sofiaprutskya-03/arc-2026/firmware/arc_robot/README.md

# Прошивка ARC 2026: маніпулятор на лінійній платформі

Плата: Keyestudio KS0413 (ESP-WROOM-32). У Arduino IDE обирайте **ESP32 Dev Module**. Ядро esp32 ставиться через Boards Manager (перевірено на 3.2.1 і 3.3.12; на Windows надійніше ставиться 3.2.1). Плати ESP32-C3/C6 не вибирати: помилка `esp-rv32 ... cc1plus.exe` означає саме неправильну плату або пошкоджене встановлення ядра.

Файли:
- `arc_robot.ino` — уся прошивка в одному файлі. Угорі блок налаштувань: піни, межі кутів, швидкості, сітка, джойстик. Усе, що залежить від заліза, змінюється тільки там. Нижче йде логіка: серво, платформа, джойстик, ручний режим, напівавтомат, ввід із клавіатури та Serial.
- `WIRING.md` — підключення і живлення.
- `BREADBOARD.md` — збирання на макетці, отвір за отвором.

## На чому побудовано

Код не писали з нуля. Усі механізми руху взяті з бібліотек у `research/references`, а модель «навчи позу → відтвори» з проєкту Keyestudio 4DOF. Огляд усіх готових проєктів: [research/ready-projects/REVIEW.md](../../research/ready-projects/REVIEW.md).

| Бібліотека | Що робить | Чому саме вона |
|---|---|---|
| ServoEasing 3.6.0 | плавні траєкторії серв (квадратичний розгін/гальмування), синхронний рух суглобів | зрілий проєкт, є приклад RobotArmControl. Працює в режимі опитування: в ESP32-гілці режиму переривань автор сам описує гонку з таймером ("CORRUPT HEAP") |
| ESP32Servo 3.2.1 | PWM 50 Гц для SG90 | потрібна ServoEasing на ESP32 |
| AccelStepper 1.64 | 28BYJ-48 + ULN2003, режим HALF4WIRE, розгін і гальмування | FastAccelStepper працює тільки з драйверами STEP/DIR, з ULN2003 він не сумісний |
| Keypad 3.1.1 | клавіатура 4x4 з подіями «натиснуто / утримується / відпущено» | ту саму бібліотеку використовує урок KS5011 «Keypad Door» |

Що додано поверх бібліотек:
1. **Ручний рух з обмеженням прискорення.** Поки клавішу тримають, суглоб плавно набирає швидкість. Коли її відпускають, суглоб плавно гальмує. Біля межі швидкість зменшується заздалегідь, тому рука не б'ється в упор.
2. **Синхронні переходи між позами.** Три суглоби стартують і зупиняються одночасно, тому траєкторія передбачувана.
3. **Горизонт клешні.** У 4-серво руці типу MeArm / Keyestudio 4DOF його тримає механіка паралелограма, тому `HAS_WRIST_SERVO false`. Якщо зап'ясток окремим серво, прошивка кожні 20 мс рахує `зап'ясток = зсув + K1·плече + K2·лікоть`.
4. **Сітка через навчання.** Позу руки над коміркою і позицію платформи виставляють руками, після чого їх записують однією клавішею. Дані зберігаються у флеш і переживають перезавантаження. На SG90 з люфтами так виходить точніше, ніж через обернену кінематику з неточними довжинами ланок.
5. **Захист позиції рейки.** Позиція рейки записується у флеш після кожної зупинки. Якщо ESP32 перезавантажився посеред руху (наприклад, просіло живлення), прошивка не довіряє збереженій позиції і просить задати нуль заново.
6. **Безпека в автоматі.** Цикл не стартує без заданого нуля. Будь-яка клавіша зупиняє все: рейка плавно гальмує, серво зупиняються на місці. Кожен крок має тайм-аут.
7. **Друк у Serial не смикає кроковий.** Для цього збільшено TX-буфер.

## Підключення

Покрокова схема з живленням від батарей: [WIRING.md](WIRING.md).

```
ULN2003  IN1 IN2 IN3 IN4  ->  GPIO 16 17 5 18
Серво    база 13 | плече 33 | лікоть 27 | клешня 25 | (зап'ясток 14, лише якщо HAS_WRIST_SERVO true)
Клавіатура 4x4 (8 дротів зліва направо): рядки 23 22 21 4, стовпці 26 14 15 19
Джойстик: X 34, Y 35, B 32, V -> 3V3, G -> GND
Кінцевик (необов'язково): GPIO 34 -> кнопка -> GND, плюс резистор 10 кОм з GPIO 34 на 3.3 В
```

Живлення:
- ESP32 живиться від USB ноутбука.
- Серво і ULN2003 живляться від окремого джерела **5–6 В** (павербанк, DC-DC або 4xAA). Відсік 6xAA (близько 9 В) напряму підключати **не можна**.
- **GND усіх джерел з'єднати разом.** Без спільної землі серво смикаються випадково.

## Збірка

Arduino IDE: скопіюйте папки з `research/references/` (ServoEasing, ESP32Servo, AccelStepper, Keypad) у `Documents/Arduino/libraries`, відкрийте `arc_robot.ino` і натисніть Upload. Якщо завантаження не стартує, утримуйте BOOT.

arduino-cli (з кореня репо):

```bash
arduino-cli compile --fqbn esp32:esp32:esp32 --library research/references/ServoEasing --library research/references/ESP32Servo --library research/references/AccelStepper --library research/references/Keypad firmware/arc_robot
```

Serial Monitor: 115200, закінчення рядка будь-яке.

## Клавіші

**Ручний режим**

| Клавіша | Дія |
|---|---|
| 4 / 6 (тримати) | платформа до нуля / від нуля |
| 2 / 8 (тримати) | рука вгору / вниз (плече) |
| 1 / 3 (тримати) | поворот бази |
| 7 / 9 (тримати) | лікоть |
| 5 | клешня відкрити / закрити |
| 0 | безпечна поза |
| # (тримати 1 с) | нуль рейки тут (з кінцевиком запускає пошук нуля) |
| A, потім цифра | записати поточну позу руки як комірку N |
| B, потім цифра | записати поточну позицію платформи як N |
| C | надрукувати стан і всю таблицю |
| D | вирівнювання клешні вкл/викл (лише з серво зап'ястка) |
| * | перейти в напівавтомат |

Ті самі символи працюють із Serial Monitor. Це запасний пульт на випадок, якщо клавіатура відмовить. З монітора клавіші руху роблять один крок: 5° або 10 мм. Додаткові команди монітора: `+`/`-` (лише з серво зап'ястка: зсув горизонту або сам зап'ясток), `x` (скинути калібрування до значень за замовчуванням), `?` (довідка).

**Джойстик (ручний режим):** X — платформа, Y — плече, кнопка — клешня. Швидкість пропорційна відхиленню ручки. База й лікоть керуються з клавіатури. Підключення описане в [WIRING.md](WIRING.md#джойстик).

**Напівавтомат:** `*`, потім 4 цифри `A B C D`, потім `#`. Відхилення джойстика або його кнопка теж працюють як СТОП. Наприклад, `* 1 2 3 1 #` означає: взяти з позиції платформи 1, комірки 2 і покласти на позицію 3, комірку 1. Якщо одразу натиснути `* #`, повториться остання задача. Під час руху будь-яка клавіша означає СТОП.

Послідовність одного циклу: відкрити клешню → безпечна поза → платформа до A → над коміркою B → повільно опустити → захват → пауза → повільно підняти → транспортна поза → платформа до C → над D → опустити → розтиснути → пауза → відвести руку → вихідна поза.

## Калібрування (зробити один раз на зібраному роботі)

1. **Межі суглобів.** Прошивка стартує з вузькими межами (60–120°, база 45–135°) і позою 90° на всіх суглобах. Рухайте кожен суглоб клавішами до краю, де ланка ще нічого не зачіпає, і розширюйте межі поступово, по 10°. Кут видно по `C`. Впишіть межі в налаштування на початку `arc_robot.ino` і перезалийте прошивку.
2. **Напрямки.** Якщо `2` опускає руку, поставте `SHOULDER_UP_DIR (-1)`. Якщо `6` везе платформу до нуля, поставте `RAIL_INVERT_DIR true`.
3. **Кроки на мм.** Задайте нуль (`#`), проїдьте `6` і порівняйте відстань на лінійці з тим, що друкує `C`. Виправте `RAIL_STEPS_PER_MM`.
4. **Горизонт клешні** (лише з серво зап'ястка). Увімкніть вирівнювання (`D`). Підніміть і опустіть плече (2/8). Якщо клешня нахиляється разом із рукою, змініть знак `WRIST_K_SHOULDER`. Те саме перевірте для ліктя (7/9) і `WRIST_K_ELBOW`. Потім виставте горизонт клавішами `+`/`-`.
5. **Сітка.** Для кожної позиції платформи підведіть її (4/6) і натисніть `B` + номер. Для кожної комірки виставте руку так, щоб клешня охоплювала вантаж, і натисніть `A` + номер. Перевірте результат через `C`.
6. **Клешня.** `CLAW_CLOSED` має стискати вантаж, але не впиратися до кінця. Інакше SG90 гуде, гріється і просаджує живлення.
7. **Прогін.** Запустіть `* 1 1 2 2 #` без вантажу, потім із вантажем. Повторіть 5–10 разів.

## Перевірка перед захистом

- [ ] Серво не смикаються при старті (спільна земля, живлення 5–6 В)
- [ ] Під навантаженням ESP32 не перезавантажується (у монітор не падає повторно банер `ARC 2026 robot`)
- [ ] Ручний тест: взяти вантаж з довільного місця й перенести
- [ ] Цикл AB→CD 5 разів поспіль без промахів
- [ ] СТОП посеред циклу зупиняє все, після нього ручний режим працює
- [ ] Після перезавантаження позиція рейки відновлюється (або прошивка просить задати нуль)

## Чого прошивка не знає

- **Пропуск кроків.** Датчика позиції немає, тому якщо 28BYJ-48 пропустить кроки (тугий хід, низька напруга), позиція рейки змістилася. Лікується так: зменшити `RAIL_MAX_SPEED`/`RAIL_ACCEL` і перед демонстрацією задати нуль заново. Кінцевик на GPIO 34 вирішує це остаточно.
- **Нахил клешні.** Без серво зап'ястка горизонт залежить від збирання паралелограма. З серво зап'ястка він розрахований, а не виміряний.
- **Порядок пінів ULN2003.** AccelStepper для 28BYJ-48 вимагає порядок IN1, IN3, IN2, IN4. Він уже зашитий у прошивку. Якщо двигун тільки гуде і дрижить, проблема в дротах, а не в коді.
