sofiaprutskya-03/arc-2026/firmware/arc_robot/BREADBOARD.md

# Збирання на макетці

Деталі з набору Keyestudio KS5011 плюс 4 серво руки:

| Деталь | Скільки | Навіщо |
|---|---|---|
| Плата ESP32 (KS0413) | 1 | керує всім, живиться від USB ноутбука |
| Модуль живлення для макетки | 1 | робить 5 В для серво й двигуна з батарей 9 В |
| Батарейний відсік 6xAA | 1 | живлення серво й двигуна |
| Макетна плата на 830 точок | 1 | з'єднання |
| Серво (SG90 / ES08MA II) | 4 | база, плече, лікоть, клешня |
| Stepper Motor Driver Board (ULN2003) | 1 | драйвер двигуна платформи |
| Кроковий двигун 28BYJ-48 | 1 | платформа |
| Мембранна клавіатура 4x4 | 1 | керування |
| Joystick Module | 1 | ручне керування |
| Дроти «тато-мама» (M-F) | 32 з 40 | ESP32, ULN2003, джойстик → макетка |
| Дроти «тато-тато» (M-M) | 20 з 30 | серво, клавіатура → макетка |
| USB-кабель | 1 | ESP32 ↔ ноутбук |

## Як влаштована макетка

- **Ряд** — номер 1–60. П'ять отворів `a b c d e` одного ряду з'єднані між собою. `f g h i j` того ж ряду теж з'єднані між собою, але **не** з `a–e`: їх розділяє жолобок посередині.
- **Шини** — довгі смуги вздовж країв. Усі отвори червоної смуги (+) з'єднані між собою, так само всі отвори синьої (−).
- Позначення `a10` означає «стовпчик a, ряд 10».

## Правила, щоб нічого не згоріло

1. **ESP32 на макетку не ставимо.** Плата лежить поруч, з'єднання йдуть проводами M-F: «мама» на штир ESP32, «тато» в отвір макетки.
2. **Пін 5V і пін 3V3 ESP32 не з'єднуються з шинами макетки.** З ESP32 на шини йде тільки GND.
3. **Перемикач напруги модуля живлення — на 5 В** (на вашому модулі це повзунок між конденсаторами з позначками 5V / 3V; якщо є жовті перемички, обидві на 5V).
4. **Батареї підключаємо останніми**, коли все зібрано й перевірено.

## Крок 1. Модуль живлення

1. Вставити модуль на **кінець макетки біля ряду 1** так, щоб його нижні штирі увійшли в обидві пари шин. Позначки `+` і `−` на модулі мають збігтися з червоною та синьою смугами.
2. Перемикач напруги поставити в положення **5V**.
3. Штекер батарейного відсіку **поки не вставляти**: він і є вимикачем живлення.

Далі в тексті «шина +5 В» і «шина GND» — це червона й синя смуги **з боку a–e**. Червону смугу з боку f–j не використовуємо.

## Крок 2. Сервоприводи (ряди 10–16)

У серво роз'єм «мама» з трьома дротами: коричневий (GND), червоний (+), помаранчевий (сигнал). У кожен отвір роз'єму вставляємо дріт M-M.

| Серво | Помаранчевий → | ESP32 (M-F) → | Червоний → | Коричневий → |
|---|---|---|---|---|
| база | `e10` | GPIO 13 → `a10` | шина +5 В | шина GND |
| плече | `e12` | GPIO 33 → `a12` | шина +5 В | шина GND |
| лікоть | `e14` | GPIO 27 → `a14` | шина +5 В | шина GND |
| клешня | `e16` | GPIO 25 → `a16` | шина +5 В | шина GND |

Перевірка: в одному ряду мають бути тільки два дроти, сигнал серво й дріт від ESP32. Ряди 11, 13, 15 лишаються порожні, щоб дроти не плутались.

## Крок 3. Двигун платформи (ряди 20–26)

1. Білий роз'єм двигуна 28BYJ-48 вставити в біле гніздо на платі ULN2003 (вставляється тільки одним боком).
2. На платі ULN2003 шість жовтих штирів: `IN1 IN2 IN3 IN4`, `+` (або `V`), `−` (або `G`). На кожен надіти «маму» дроту M-F.

| Штир ULN2003 | Куди «тато» | ESP32 (M-F) → |
|---|---|---|
| IN1 | `e20` | GPIO 16 → `a20` |
| IN2 | `e22` | GPIO 17 → `a22` |
| IN3 | `e24` | GPIO 5 → `a24` |
| IN4 | `e26` | GPIO 18 → `a26` |
| + (V) | шина +5 В | — |
| − (G) | шина GND | — |

## Крок 4. Клавіатура 4x4 (ряди 30–37)

У шлейфа клавіатури 8 контактів «мама». Якщо тримати клавіатуру лицем до себе, рахуємо їх зліва направо 1–8. У кожен вставити дріт M-M.

| Контакт шлейфу | Куди | ESP32 (M-F) → |
|---|---|---|
| 1 (рядок 1) | `j30` | GPIO 23 → `f30` |
| 2 (рядок 2) | `j31` | GPIO 22 → `f31` |
| 3 (рядок 3) | `j32` | GPIO 21 → `f32` |
| 4 (рядок 4) | `j33` | GPIO 4 → `f33` |
| 5 (стовпець 1) | `j34` | GPIO 26 → `f34` |
| 6 (стовпець 2) | `j35` | GPIO 14 → `f35` |
| 7 (стовпець 3) | `j36` | GPIO 15 → `f36` |
| 8 (стовпець 4) | `j37` | GPIO 19 → `f37` |

Клавіатурі живлення не потрібне.

## Крок 5. Джойстик (ряди 42–48)

На модулі джойстика 5 штирів: `Y X B V G`. На кожен надіти «маму» дроту M-F.

| Штир джойстика | Куди «тато» | ESP32 (M-F) → |
|---|---|---|
| X | `j42` | GPIO 34 → `f42` |
| Y | `j44` | GPIO 35 → `f44` |
| B | `j46` | GPIO 32 → `f46` |
| V | `j48` | **3V3** → `f48` |
| G | синя шина з боку f–j (GND) | — |

**Ряд 48 — це живлення 3,3 В від ESP32. Він не з'єднується з жодною шиною.** Якщо V джойстика потрапить на +5 В, можна пошкодити входи ESP32.

## Крок 6. Спільна земля

Один дріт M-F: «мама» на пін **GND** ESP32, «тато» в **шину GND** з боку a–e.

Без цього дроту серво не розуміють сигнал і смикаються. Живлення через нього не йде, він тільки вирівнює рівень «нуля».

## Крок 7. Перевірка перед увімкненням

- [ ] ESP32 не стоїть на макетці і з'єднаний з нею лише проводами.
- [ ] Жоден дріт не йде з піна **5V** ESP32.
- [ ] З піна **3V3** ESP32 іде тільки один дріт, у `f48` (джойстик).
- [ ] Червона шина з боку f–j порожня.
- [ ] Червоні дроти серво й `+` ULN2003 — у червоній шині з боку a–e.
- [ ] Коричневі дроти серво, `−` ULN2003 і GND ESP32 — у синій шині з боку a–e.
- [ ] Перемикач напруги модуля на 5V.
- [ ] У рядах 10–26 і 30–48 у кожному ряду рівно 2 дроти.

## Крок 8. Увімкнення

1. USB-кабелем з'єднати ESP32 з ноутбуком і залити прошивку. Батареї ще відключені.
2. Serial Monitor, 115200: має з'явитися довідка і рядок «Джойстик: центр ...».
3. Вставити штекер батарей у DC-гніздо модуля (якщо на модулі є кнопка, увімкнути її): засвітиться його світлодіод.
4. Серво стануть у 90°. Далі діємо за [WIRING.md](WIRING.md), розділ «Порядок першого вмикання»: перевіряємо суглоби по одному, короткими натисканнями.

Якщо щось гуде, гріється або ESP32 перезавантажується: **одразу вийняти штекер батарей з модуля.**
