sofiaprutskya-03/arc-2026/research/ready-projects/REVIEW.md

# Огляд готових проєктів

Мета: знайти робочий код для 4-серво руки (база, плече, лікоть, клешня на SG90) на ESP32 із лінійною платформою і взяти з нього найкраще, а не писати з нуля.

## Підсумок

| Проєкт | Залізо | Що в ньому добре | Чому не основа | Що взяли |
|---|---|---|---|---|
| `arduino-4dof-robot-arm` | Keyestudio 4DOF (KS0198), Uno, 4 SG90, 2 джойстики | та сама механіка, перевірені стартові кути й межі, запис і відтворення поз | AVR, блокуючі `delay`, серво рухаються по черзі, джойстик тільки вкл/викл | стартові кути, межі, модель «навчити позу → відтворити» |
| ServoEasing `RobotArmControl` (у `research/references`) | MeArm V0.4, 4 серво | плавні траєкторії, обернена кінематика для MeArm у мм | AVR-орієнтований, режим переривань на ESP32 має гонку з таймером | бібліотека ServoEasing у режимі опитування; IK лишається запасним варіантом |
| `ESP32-4-DOF-Robotic-Arm-with-Custom-Web-Dashboard` | ESP32 + PCA9685, 5 серво | неблокуючий цикл, розгін/гальмування, збереження поз, аварійна зупинка | потрібен PCA9685 і Wi-Fi, яких немає | профіль руху з гальмуванням перед ціллю (у нас через обмеження прискорення) |
| `ESP32-6DOF-Robotic-Arm` | ESP32 + PCA9685, 6 серво | калібрування кожного суглоба з монітора, межі в одному масиві | блокуючі розгортки, 6 DOF | калібрування з Serial Monitor |
| `ESP32-Robotic-Arm` | ESP32, 4 серво, AsyncWebServer, OpenCV | веб-повзунки | серво пишуться напряму без згладжування, потрібен ПК з Python | нічого |
| `GestureArm` | 2 ESP32, MPU6050, крокові STEP/DIR | ESP-NOW, жести | інша механіка й драйвери | нічого |

## Висновок

Найближчий до вашого робота `arduino-4dof-robot-arm`: це та сама 4-серво рука Keyestudio. Його логіка проста: виставити позу джойстиком, запам'ятати, відтворити. Але рух там блокуючий і по одному серво за раз, тому для плавного руху й напівавтомата його треба переробити.

Наша прошивка (`firmware/arc_robot`) зберігає цю модель «навчи і відтвори» та додає:
- рух через ServoEasing замість `write()` у циклі з `delay(5)`: суглоби рухаються синхронно й плавно;
- неблокуючий цикл, тому платформа, клавіатура й серво працюють одночасно;
- комірки сітки, які зберігаються у флеш і не губляться після перезавантаження;
- платформу на AccelStepper.

## Стартові значення з Keyestudio 4DOF

Взяті з `arduino-4dof-robot-arm/joystick_control/dual_joystick_control.ino` (перевірені на тій самій механіці; ваша збірка може відрізнятися напрямом качалок):

| Серво | Пін у Keyestudio | Старт | Межі |
|---|---|---|---|
| база | A1 | 80 | 1–180 |
| права ланка (плече) | A0 | 60 | 0–180 |
| ліва ланка (лікоть) | D6 | 130 | 35–180 |
| клешня | D9 | 0 | 2 (стиснута) – 108 (відкрита) |

Ці числа використовуйте як першу спробу в налаштуваннях на початку `arc_robot.ino`, а потім уточніть клавішами на реальному роботі.

## Що лишається відкритим

- **Двигун платформи.** На фото IMG_5151 сервопривод SG90 у основі руки, а не кроковий двигун. Тип приводу платформи ще треба підтвердити: 28BYJ-48 з ULN2003 чи інший.
- **Кінцевика немає.** Прошивка розрахована на ручне задання нуля.
