sofiaprutskya-03/arc-2026/research/ready-projects/ESP32-6DOF-Robotic-Arm/assets/circuit_diagram.png

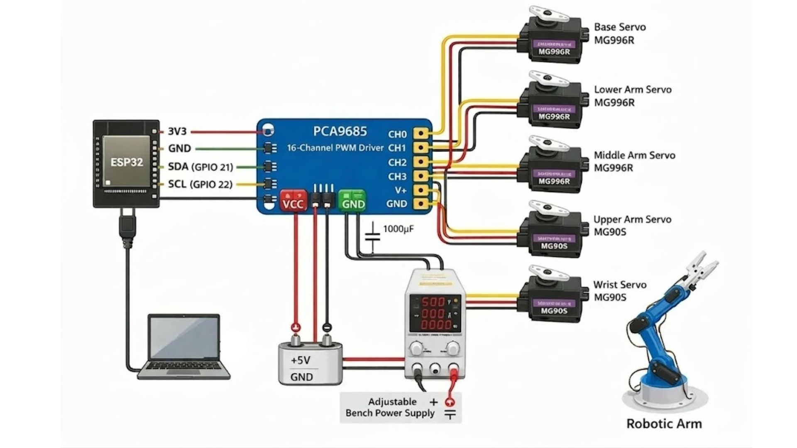
research/ready-projects/ESP32-6DOF-Robotic-Arm/assets/circuit_diagram.png
