sofiaprutskya-03/arc-2026/firmware/arc_robot/WIRING.md

# Підключення

Покрокове збирання на макетці, отвір за отвором: [BREADBOARD.md](BREADBOARD.md).

Залізо з фото: ESP32 KS0413, модуль живлення для макетки (DC-гніздо, mini-USB, перемички 5 В / 3,3 В, запобіжник 1,5 А), макетна плата на 830 точок, 4 серво (SG90 і EMAX ES08MA II), плата ULN2003 Keyestudio з двигуном 28BYJ-48 5VDC, мембранна клавіатура 4x4, відсік 6xAA (UM-3x6) зі штекером DC, аналоговий джойстик Keyestudio (ручний режим).

## Живлення: головне правило

**Відсік 6xAA дає близько 9 В. Напряму до серво й до ULN2003 його не підключати**: SG90 розраховані на 4,8–6 В і згорять. Напругу знижує модуль живлення макетки.

```
 Батареї 6xAA (9 В) ── штекер ──> DC-гніздо модуля живлення
                                  модуль стоїть на краю макетки, перемички на 5 В
 Шина +5 В ──┬── червоні дроти 4 серво
             └── «+» (VCC) на ULN2003
 Шина GND ───┬── коричневі дроти 4 серво
             ├── «−» (GND) на ULN2003
             └── GND ESP32        <- обов'язково, без цього серво смикаються
 ESP32 ───── USB ноутбука         <- живлення ESP32 тільки звідси
```

Перед першим вмиканням:

1. **Обидві перемички модуля — у положення 5 В.** На 3,3 В серво слабкі й смикаються.
2. **Шина 5 В модуля не з'єднується з ESP32.** Ні з 5V/VIN, ні тим паче з 3V3, коли ESP32 живиться від USB. З ESP32 на макетку йде тільки GND.
3. **Струм модуля обмежений** (стабілізатор приблизно на 1 А, запобіжник 1,5 А). Чотири серво під навантаженням одночасно можуть просадити напругу. Тоді серво смикаються, а модуль гріється. Тому в ручному режимі рухаємо по одному суглобу, а клешню не стискаємо до упору.
4. Якщо модуль сильно гріється: від'єднати батареї й дати охолонути. Запасний варіант живлення — павербанк у mini-USB гніздо модуля (5 В без стабілізатора).

Якщо модуля немає, підійдуть 4 батарейки AA і перемички у двох порожніх слотах відсіку (~6 В, на межі для SG90).

## Джойстик

Керує ручним режимом разом із клавіатурою: X — платформа, Y — плече, кнопка — клешня. Чим сильніше відхилити ручку, тим швидше рух.

| Контакт джойстика | ESP32 |
|---|---|
| V (VCC) | **3V3** (не шина 5 В!) |
| G (GND) | GND |
| X | GPIO 34 |
| Y | GPIO 35 |
| B (кнопка) | GPIO 32 |

**V — тільки на 3V3 ESP32.** Від 5 В на виходах X/Y буде до 5 В, а входи ESP32 витримують лише 3,3 В.

Під час увімкнення ручку не чіпати: прошивка в цей момент запам'ятовує центр. Якщо центр нестабільний або джойстик не підключений, він вимикається сам, а в Serial Monitor з'являється «Джойстик ВИМКНЕНО». Напрямки перевертаються в налаштуваннях на початку `arc_robot.ino` (`JOY_INVERT_X`, `JOY_INVERT_Y`). Вимкнути джойстик повністю можна через `JOYSTICK_ENABLED false`.

## Сервоприводи

У SG90 і EMAX ES08MA II однакові роз'єми: коричневий = GND, червоний = живлення, помаранчевий = сигнал. Роз'єм «мама» з'єднується з шинами й ESP32 перемичками «тато-тато». ES08MA II з металевими шестернями краще ставити на плече: воно найбільше навантажене.

| Серво | Помаранчевий (сигнал) → ESP32 | Червоний | Коричневий |
|---|---|---|---|
| база (поворот) | GPIO 13 | шина +5–6 В | шина GND |
| плече (перша ланка, вгору/вниз) | GPIO 33 | шина +5–6 В | шина GND |
| лікоть (друга ланка, виліт) | GPIO 27 | шина +5–6 В | шина GND |
| клешня | GPIO 25 | шина +5–6 В | шина GND |

Якщо невідомо, яке серво яке: підключіть по одному, натискайте `1/3`, `2/8`, `7/9`, `5` і дивіться, що рухається. Переставляти можна дроти або номери пінів у налаштуваннях на початку `arc_robot.ino`.

Перед першим вмиканням краще зняти качалки (або тримати руку). Прошивка на старті ставить серво в безпечну позу з налаштувань на початку `arc_robot.ino`, а реальні межі ще не відкалібровані.

## Кроковий двигун платформи

28BYJ-48 вставляється білим роз'ємом у плату ULN2003. Плата з'єднується з ESP32 так:

| ULN2003 | ESP32 |
|---|---|
| IN1 | GPIO 16 |
| IN2 | GPIO 17 |
| IN3 | GPIO 5 |
| IN4 | GPIO 18 |
| + | шина +5–6 В |
| − | шина GND |

Якщо двигун гуде і дрижить, але не крутиться, перевірте порядок IN1–IN4.

## Клавіатура 4x4

Шлейф має 8 контактів. Якщо тримати клавіатуру лицем до себе, контакти зліва направо — це рядки 1–4, потім стовпці 1–4:

| Контакт шлейфу | 1 | 2 | 3 | 4 | 5 | 6 | 7 | 8 |
|---|---|---|---|---|---|---|---|---|
| ESP32 | GPIO 23 | GPIO 22 | GPIO 21 | GPIO 4 | GPIO 26 | GPIO 14 | GPIO 15 | GPIO 19 |

Перевірка: натисніть `C`. Якщо в Serial Monitor з'явилась таблиця, клавіатура підключена правильно. Якщо клавіші переплутані, розверніть шлейф або поміняйте піни в `KEYPAD_ROW_PINS` / `KEYPAD_COL_PINS`.

## ІЧ-пульт

Не використовується. Керування тільки з клавіатури 4x4: вона підключена дротом і передає утримання клавіші, на якому тримається плавний ручний рух. Запасний варіант — команди з Serial Monitor.

## Порядок першого вмикання

Мета: якщо щось підключено не так, помітити це до того, як серво перегріється.

1. **Перевірити живлення без навантаження.** Батареї в модулі, перемички на 5 В, світиться світлодіод модуля. Мультиметром на шинах має бути близько 5 В. Не 9 В.
2. **ESP32 тільки від USB, жодне серво не підключене.** Залити прошивку, відкрити Serial Monitor (115200), переконатися, що з'явилась довідка. Перевірити клавіатуру: `C` друкує стан.
3. **Підключити ОДНЕ серво**, наприклад базу, і з'єднати GND ESP32 із шиною GND. Подати батареї. Серво стане в 90°. Натискати коротко `1`/`3`.
4. **Ознаки проблеми — одразу від'єднати батареї:** серво гуде, не рухаючись; корпус теплий на дотик; ESP32 перезавантажується (у монітор знову падає банер `ARC 2026 robot`).
5. Повторити крок 3 для плеча (`2`/`8`), ліктя (`7`/`9`) і клешні (`5`). Тільки після цього підключити всі разом.
6. Двигун платформи підключати останнім. Перший рух робити клавішами `4`/`6` короткими натисканнями.
7. Межі розширювати поступово, за README, розділ «Калібрування».

Батарейний відсік має бути під рукою, щоб його можна було швидко від'єднати.
