sofiaprutskya-03/arc-2026/research/ready-projects/arduino-4dof-robot-arm/basic_programs/servo_control/servo_control.ino

#include <Servo.h>
Servo myservo1;  // create servo object to control a servo
Servo myservo2;
Servo myservo3;
Servo myservo4;
int pos1=80, pos2=60, pos3=130, pos4=0;

void setup()
{
  myservo1.attach(A1);  // attaches the servo on pin 9 to the servo object
  myservo2.attach(A0);
  myservo3.attach(6);
  myservo4.attach(9);

  myservo1.write(pos1);
  delay(1000);
  myservo2.write(pos2);
  myservo3.write(pos3);
  myservo4.write(pos4);
  delay(1500);
}

void loop()
{
  // turn right
  for(pos1;pos1>0;pos1--)
  {
    myservo1.write(pos1);
    delay(5);      // delay 5ms（used to adjust the servo speed）
  }
  delay(1000);

  // open the claw
 for(pos4;pos4<100;pos4++)
 {
   myservo4.write(pos4);
 }
  delay(1000);

  // move the right-side arm servo from 60 to 50 degrees
  for(pos2;pos2>50;pos2--)
  {
    myservo2.write(pos2);
    delay(5);
  }
  // move the left-side arm servo from 130 to 50 degrees
  for(pos3;pos3>50;pos3--)
  {
    myservo3.write(pos3);
    delay(5);
  }
  delay(1500);

  // close the claw
  for(pos4;pos4>0;pos4--)
  {
    myservo4.write(pos4);
  }
  delay(1000);

  // left servo rotates to100 degrees, rocker arm lifts.
  for(pos3;pos3<120;pos3++)
  {
    myservo3.write(pos3);
    delay(5);
  }
  delay(1000);

  // turn to left
  for(pos1;pos1<180;pos1++)
  {
    myservo1.write(pos1);
    delay(5);
  }
  delay(1000);

  // Lower the arm
  for(pos3;pos3>50;pos3--)
  {
    myservo3.write(pos3);
    delay(5);
  }
  delay(1000);

  // open the claw
  for(pos4;pos4<100;pos4++)
  {
    myservo4.write(pos4);
  }
  delay(1000);

  // lift up the arm
  for(pos3;pos3<120;pos3++)
  {
    myservo3.write(pos3);
    delay(5);
  }
  delay(1000);

  // close the claw
  for(pos4;pos4>0;pos4--)
  {
    myservo4.write(pos4);
  }
  delay(1000);
}
