sofiaprutskya-03/arc-2026/(commit log)

2026-10-24 Add ESP32 research notes for ARC 2026
2026-10-24 Add arm control: synced pose moves, smooth jog, wrist leveling
2026-10-24 Add linear rail control with homing and position persistence
2026-10-24 Add calibration storage in NVS
2026-10-24 Add firmware README with wiring, controls and calibration
2026-10-24 Add open-source robotic arm reference projects
2026-10-24 Add HAS_WRIST_SERVO option, off for 4-servo MeArm-style arm
2026-10-24 Skip wrist servo and leveling when arm has no wrist servo
2026-10-24 Add review of ready-made robotic arm projects
2026-10-24 Update firmware README for 4-servo arm without wrist servo
2026-10-24 Add wiring and battery power guide
2026-10-24 Link wiring guide from firmware README
2026-10-24 Move shoulder servo off GPIO 14, which pulses during boot
2026-10-24 Start with narrow joint limits and neutral 90 degree safe pose
2026-10-24 Refuse auto run until used grid cells and rail slots are taught
2026-10-24 Add staged first power-on procedure to wiring guide
2026-10-24 Document breadboard power module and joystick voltage limit in wiring guide
2026-10-24 Add joystick control for rail, shoulder and claw in manual mode
2026-10-24 Document joystick wiring on 3V3 and pins 34, 35, 14
2026-10-24 Add hole-by-hole breadboard assembly guide
2026-10-24 Link breadboard guide from wiring guide
2026-10-24 Match joystick button to GPIO 32 as wired, move keypad columns to 33, 14, 15, 5
2026-10-24 Reject pin conflicts and invalid GPIO choices at compile time
2026-10-24 Update docs for joystick button on GPIO 32 and new keypad columns
2026-10-24 Match shoulder servo to GPIO 33 as wired, move keypad column to 26
2026-10-24 Match stepper IN3 and IN4 to GPIO 5 and 18 as wired, move keypad column to 19
2026-10-24 Update docs for stepper on GPIO 16, 17, 5, 18 and keypad column on 19
2026-10-24 Skip rail moves to the current position so the moving flag is not left set
2026-10-24 Require taught home slot before auto run when return-to-home is enabled
2026-10-24 Remove unused joint names, armBusy and homing timestamp
2026-10-24 Note GPIO 5 boot pulses next to stepper pins
2026-10-24 Note tested ESP32 core versions and the rv32 toolchain error in README
2026-10-25 Add team's joystick and keypad arm sketch
2026-10-25 Smooth arm motion with accel limits, joint limits, calibrated joystick and home key
2026-10-25 Start arm at 0 degrees to match its resting position
2026-10-25 Drive shoulder, elbow and claw as independent positional joints
2026-10-25 Restore 360-degree claw control and trim settings to speed and claw stop
2026-10-25 Reduce arm sketch to plain manual control: keypad selects joint, joystick moves it
2026-10-25 Start all joints at 90 degrees so each can move both ways
2026-10-25 Power each servo only when its joint is first selected
2026-10-25 Add servo sweep test sketch
